jaredhumphreys3141/ZEPHYR-X1000/PerformanceLog.txt

Number of Contacts: 0
Number of contact data: 0
