jaredhumphreys3141/ZEPHYR-X1000/ZEPHYR-X1000 - ROCKET PROPULSION SUBASSY.SLDASM

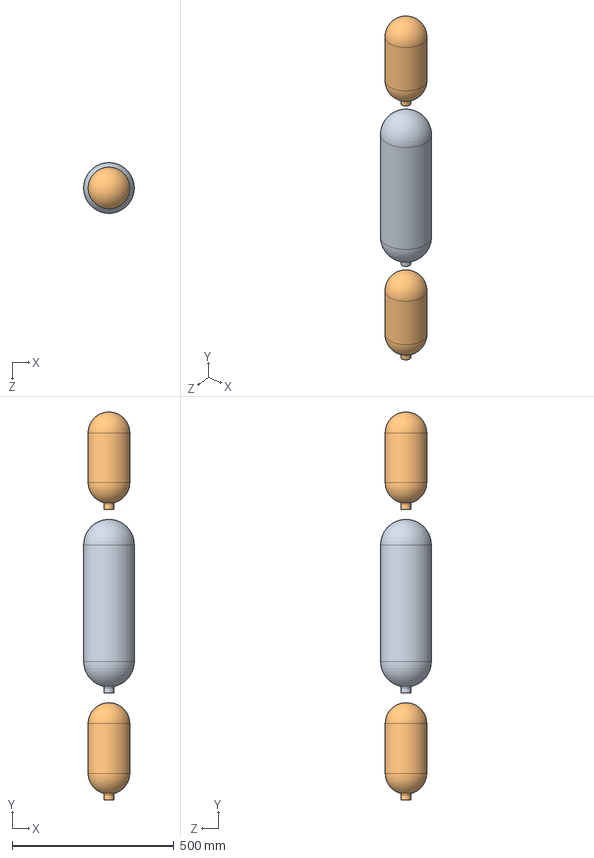
[picture p1: CAD file, 2026-06-25]
ZEPHYR-X1000 - ROCKET PROPULSION SUBASSY.SLDASM
156.8 x 1200.6 x 157.0 mm
6.8L PRESSURE TANK - COPV
2.5L PRESSURE TANK - COPV x 2
