jaredhumphreys3141/ZEPHYR-X1000/COTS CAD/SR48.step

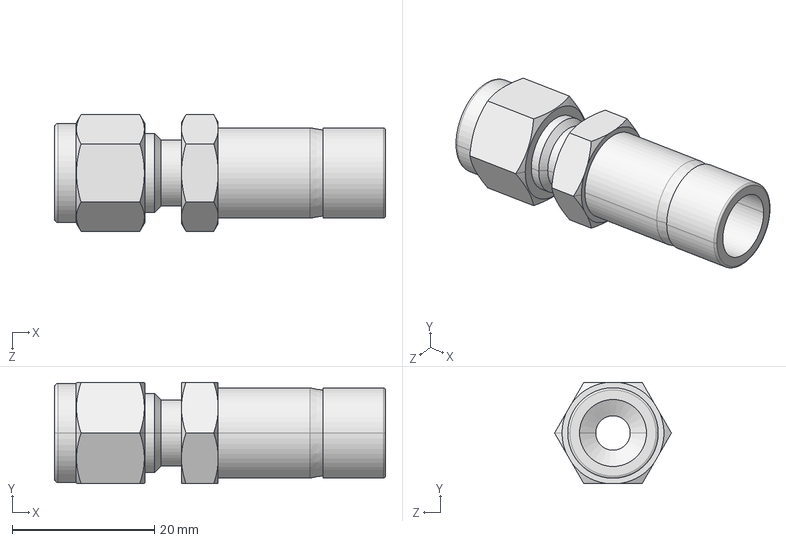
[picture p2: CAD file, 2026-07-01]
COTS CAD/SR48.step
46.5 x 14.2 x 16.4 mm
