jaredhumphreys3141/ZEPHYR-X1000/STEP FILES/ZEPHYR-X1000 - END CAP.STEP

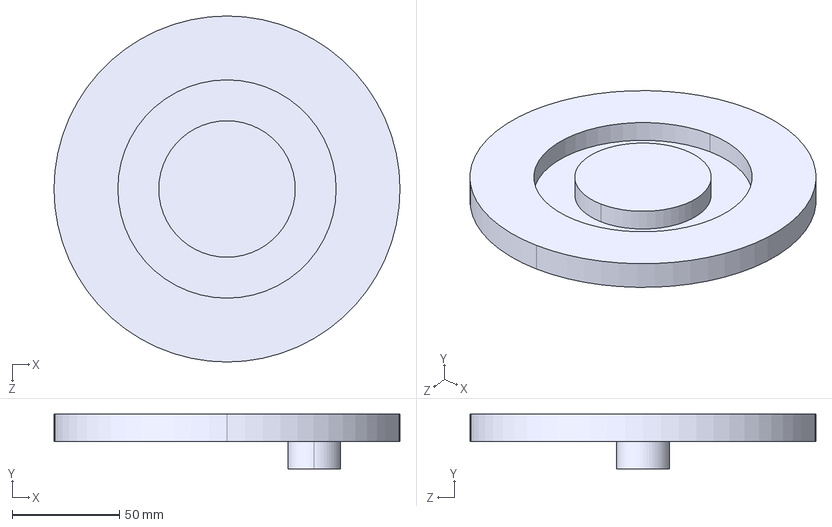
[picture p3: CAD file, 2026-07-16]
STEP FILES/ZEPHYR-X1000 - END CAP.STEP
161.0 x 25.4 x 161.0 mm
