jaredhumphreys3141/ZEPHYR-X1000/ZEPHYR-X1000 - COAXIAL TANK VOLUME.SLDPRT

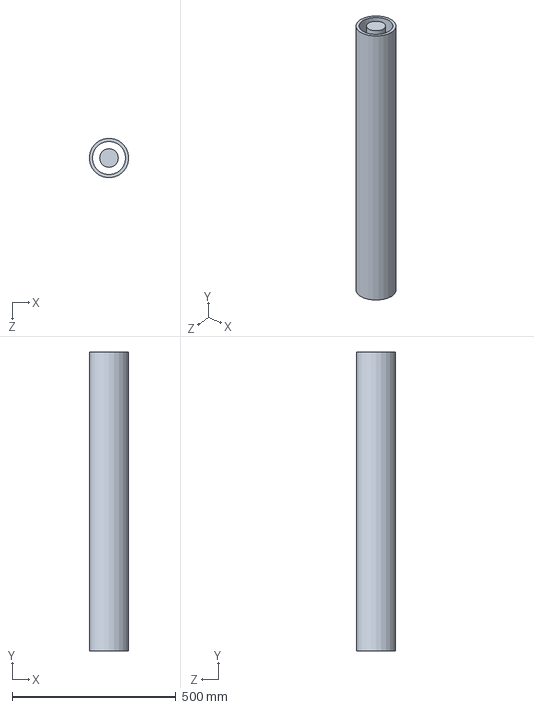
[picture p4: CAD file, 2026-07-16]
ZEPHYR-X1000 - COAXIAL TANK VOLUME.SLDPRT
120.7 x 914.4 x 120.7 mm
