jaredhumphreys3141/ZEPHYR-X1000/J1926 O RING BOSS PORT CUTTING TOOL.SLDPRT

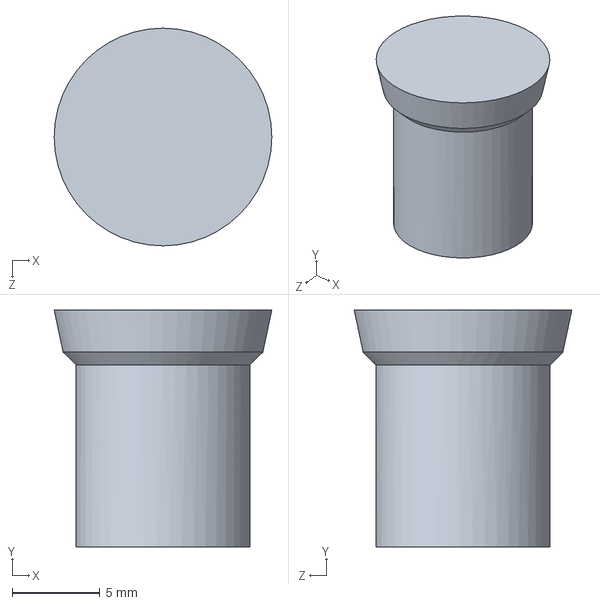
[picture p5: CAD file, 2026-07-16]
J1926 O RING BOSS PORT CUTTING TOOL.SLDPRT
12.4 x 13.5 x 12.4 mm
