jaredhumphreys3141/ZEPHYR-X1000/ZEPHYR-X1000 - TANK WALL.SLDPRT

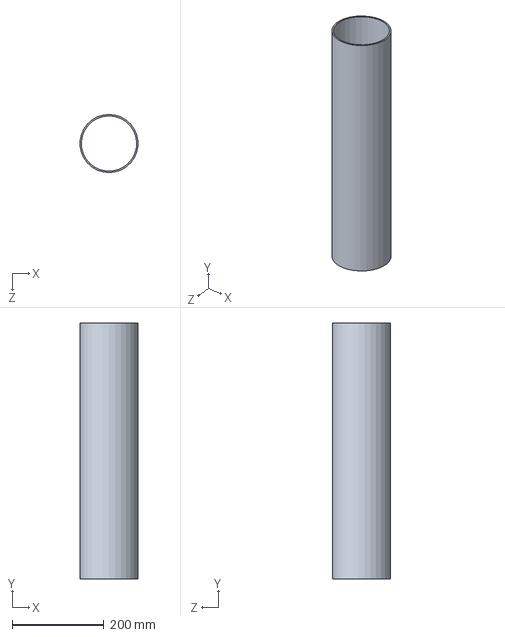
[picture p6: CAD file, 2026-07-16]
ZEPHYR-X1000 - TANK WALL.SLDPRT
126.3 x 558.8 x 127.0 mm
