jaredhumphreys3141/ZEPHYR-X1000/ZEPHYR-X1000 - TANK MANIFOLD.SLDPRT

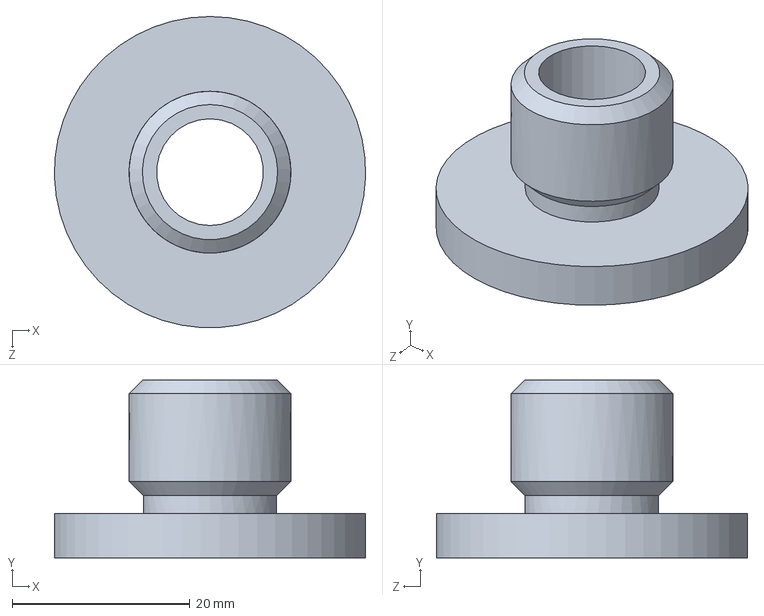
[picture p7: CAD file, 2026-07-06]
ZEPHYR-X1000 - TANK MANIFOLD.SLDPRT
35.0 x 20.0 x 35.0 mm
