jaredhumphreys3141/ZEPHYR-X1000/SAE J1926 ORB PORT.SLDPRT

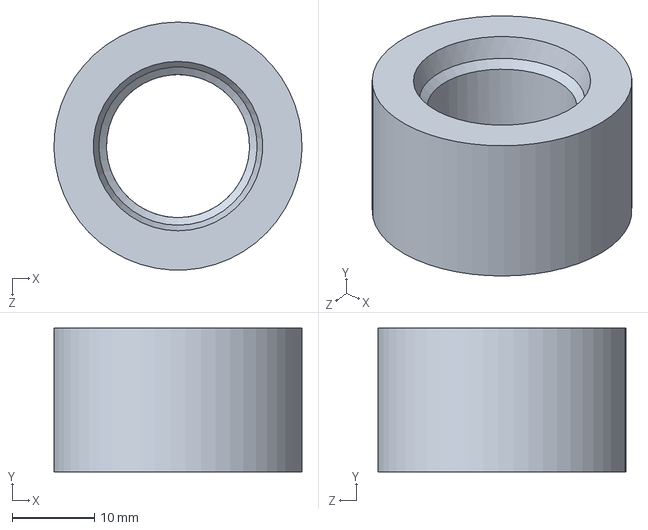
[picture p8: CAD file, 2026-07-06]
SAE J1926 ORB PORT.SLDPRT
30.2 x 17.5 x 30.1 mm
