jaredhumphreys3141/ZEPHYR-X1000/6.8L PRESSURE TANK - COPV.SLDPRT

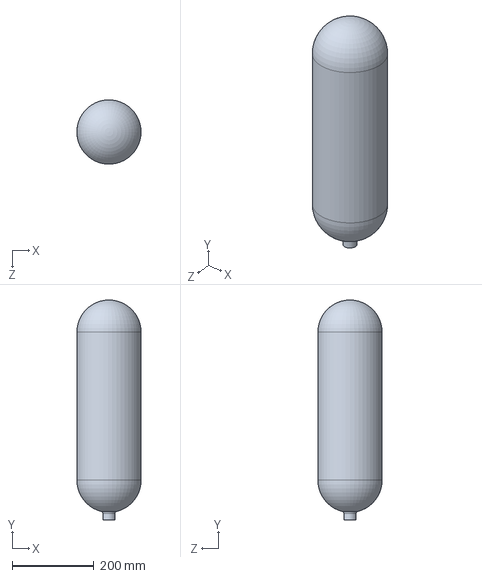
[picture p9: CAD file, 2026-06-25]
6.8L PRESSURE TANK - COPV.SLDPRT
156.8 x 537.0 x 157.0 mm
