jaredhumphreys3141/ZEPHYR-X1000/2.5L PRESSURE TANK - COPV.SLDPRT

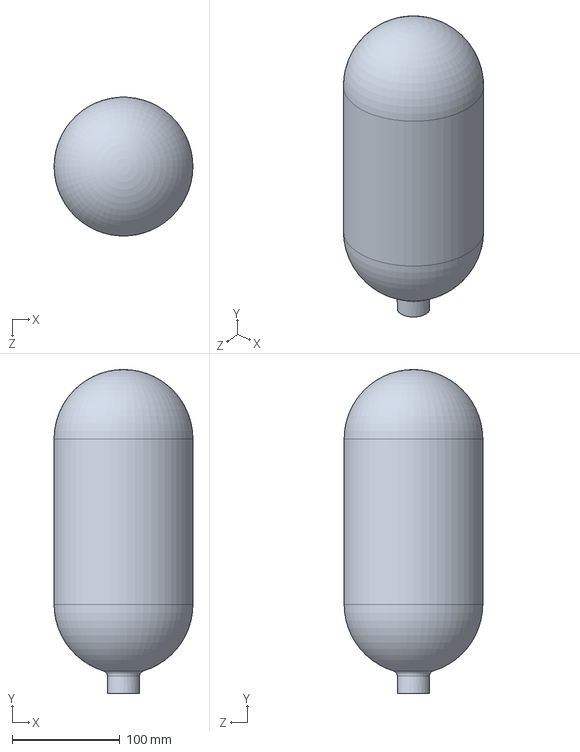
[picture p10: CAD file, 2026-06-25]
2.5L PRESSURE TANK - COPV.SLDPRT
129.0 x 301.0 x 128.9 mm
