jaredhumphreys3141/ZEPHYR-X1000/3L PRESSURE TANK - COPV.SLDPRT

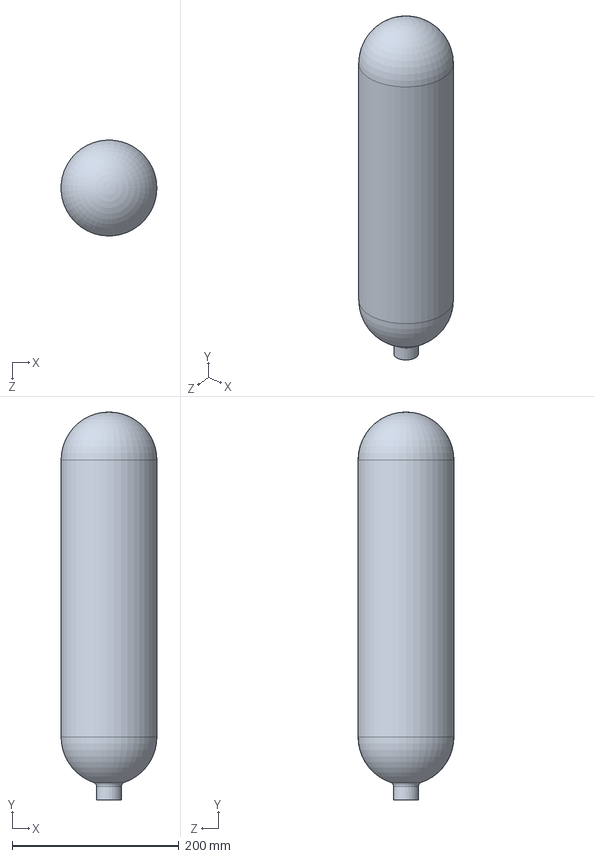
[picture p11: CAD file, 2026-06-25]
3L PRESSURE TANK - COPV.SLDPRT
114.8 x 465.0 x 115.0 mm
