jaredhumphreys3141/ZEPHYR-X1000/LEGACY/ZEPHYR-X1000 - END CAP 2026-07-07.SLDPRT

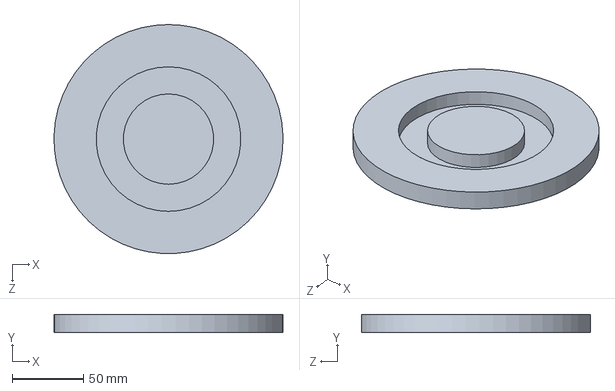
[picture p12: CAD file, 2026-07-16, an earlier design]
LEGACY/ZEPHYR-X1000 - END CAP 2026-07-07.SLDPRT
161.0 x 12.7 x 160.9 mm
