jaredhumphreys3141/ZEPHYR-X1000/(list of files, cad)

Other CAD files:
JIC MALE FLARE FITTING.SLDPRT
ZEPHYR-X1000 - END CAP.SLDPRT
