jaredhumphreys3141/ZEPHYR-X1000/(commit log)

2026-06-25 Created rocket propulsion subassy and added COPV tanks
    [2.5L PRESSURE TANK - COPV.SLDPRT, 3L PRESSURE TANK - COPV.SLDPRT, 6.8L PRESSURE TANK - COPV.SLDPRT, ZEPHYR-X1000 - ROCKET PROPULSION SUBASSY.SLDASM]
2026-07-06 Created end cap
    [J1926 O RING BOSS PORT CUTTING TOOL.SLDPRT, JIC MALE FLARE FITTING.SLDPRT, SAE J1926 ORB PORT.SLDPRT, ZEPHYR-X1000 - END CAP.SLDPRT, ZEPHYR-X1000 - END CAP.STEP, ZEPHYR-X1000 - TANK MANIFOLD.SLDPRT]
2026-07-16 TANK SIMULATION
    [J1926 O RING BOSS PORT CUTTING TOOL.SLDPRT, ZEPHYR-X1000 - COAXIAL TANK VOLUME.SLDPRT, ZEPHYR-X1000 - END CAP 2026-07-07.SLDPRT, ZEPHYR-X1000 - END CAP.STEP, ZEPHYR-X1000 - TANK WALL.SLDPRT]
2026-11-02 Create ROTATING AND POSITIVE DISPLACEMENT PUMPS FOR LOW THRUST ROCKET ENGINES NASA PAPER.pdf
